eskutcheon/Purr-Patrol-Turret/assets/STLs/motor_bracket.stl

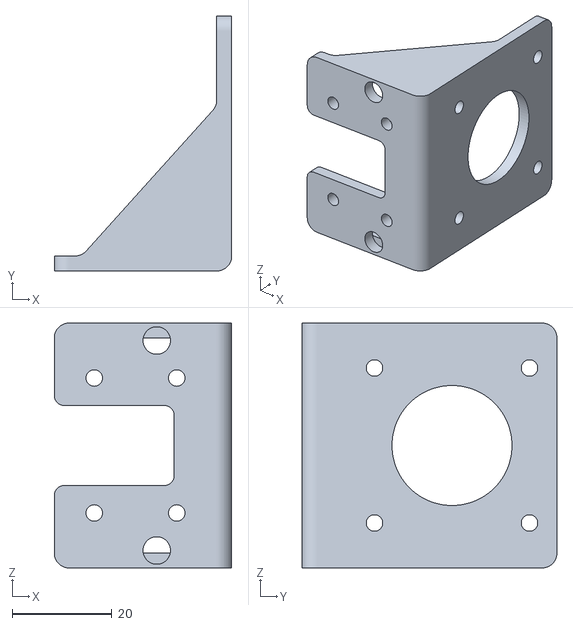
[picture p1: CAD file, 2025-03-24]
assets/STLs/motor_bracket.stl
35.5 x 51.0 x 49.0
