eskutcheon/Purr-Patrol-Turret/assets/STLs/flanged_shaft.stl

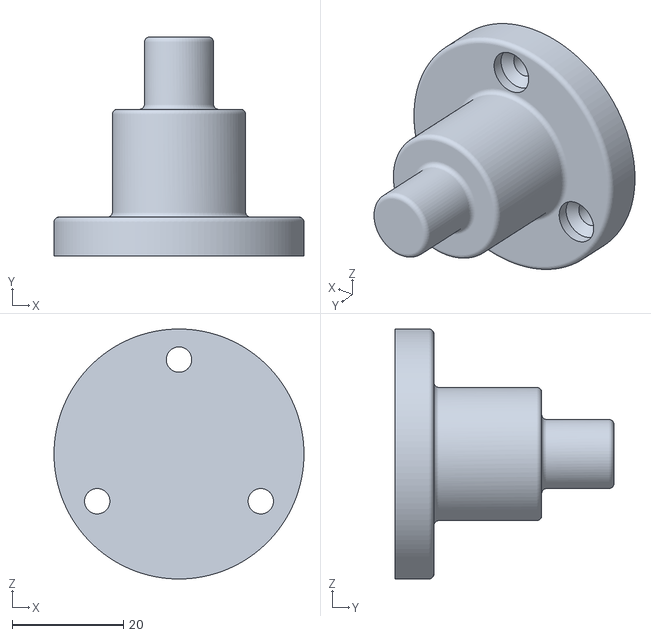
[picture p2: CAD file, 2025-03-24]
assets/STLs/flanged_shaft.stl
45.0 x 39.4 x 45.0
