eskutcheon/Purr-Patrol-Turret/assets/STLs/flanged_collar_prototype.stl

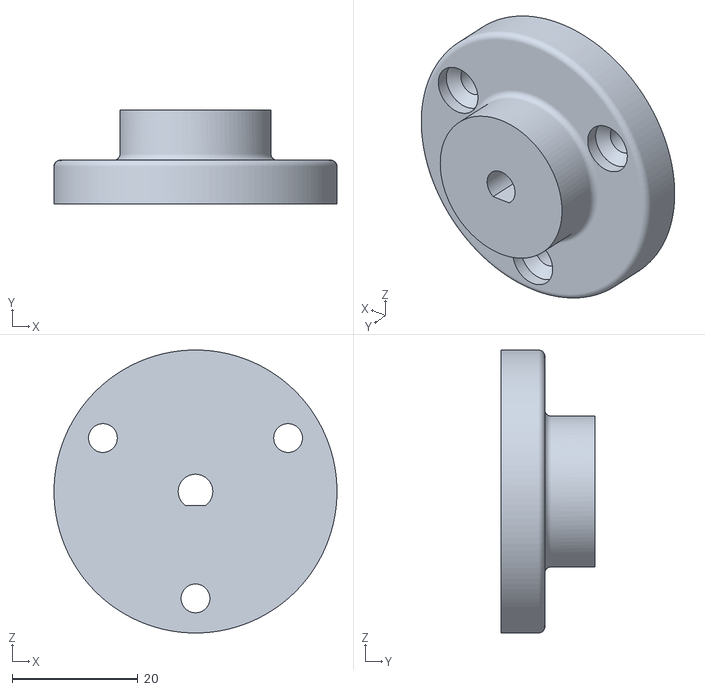
[picture p3: CAD file, 2025-03-24]
assets/STLs/flanged_collar_prototype.stl
45.0 x 15.0 x 45.0
