eskutcheon/Purr-Patrol-Turret/(commit log)

2023-11-06 moved VideoUtils to motion_tracking.py and replaced dependency on deprecated imutils library
    [motion_tracking.py, turret.py]
2023-11-08 added some docs to the repo and made some minor changes to scripts
    [Jetson-Nano-GPIO-mapping.xlsx]
2023-11-19 ongoing tests for motor driver
2023-11-19 added power relay test
2023-11-19 just adding traceback for tests here to review later on another device
2023-11-30 added comments with stuff to do and rewrote a couple redundant snippets in the Turret class
2023-12-05 implemented non-maximum suppression in the box filtering function
2023-12-06 finished targeting code - need to play with threshold and adjust for camera offset
2024-12-24 started working on integrating the object detection better before I end up unplugging my Raspberry Pi and trying the motorhat tests with the Adafruit libraries again
2025-01-22 separated the turret and basic controller logic to support the different modes and aid calibration - will be further extended for operating the turret using the controller as an entry point
    [Jetson-Nano-GPIO-mapping.xlsx]
2025-01-31 started work on camera calibration code based on an algorithm (Zhang 1998) for finding corners on certain calibration pattern and started working on targeting code along with it
2025-02-13 joined relay.py and motor.py into hardward.py, fixed interactive mode and added new methods to test, and fixed minor errors here and there
    [camera.py, controller.py, hardware.py, operations.py, targeting.py, utils.py]
2025-02-14 added a new state to hopefully take over interactive mode tasks - untested until running on Raspberry Pi
2025-02-14 refactored some things into the targeting system, finished adding type annotations, and started working on integrating live camera feeds
2025-02-20 updated the object detection code, confirmed that it was working, and added a couple new networks as Detector options
2025-02-21 committing whatever remains to merge what I've got since I've confirmed the basic camera and turret operations are working
2025-02-25 adding calibration mode to try one last time to compute camera parameters using the new Raspberry Pi camera, described in the new docs
2025-02-28 various changes all over the place as I test this - might have to entirely replace the current motion detector since the method of finding connected components is so much more memory-hungry than I th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
    [camera.py, command.py, controller.py, hardware.py, operations.py, state.py]
2025-02-28 completely rewrote the motion detector back to a numpy and skimage implementation to run on CPU and updated their commands accordingly - also resolved devices in the detectors
    [command.py, controller.py, state.py, test_monitoring.py]
2025-03-01 added logging to the camera feed to better debug things when the Raspberry Pi fails to capture a frame.
    [camera.py]
2025-03-01 changed the threading used in the live video feed display to ensure that unexpected blocking behavior wouldn't happen on the Pi
2025-03-03 added texture map weighting to the motion tracking mask to avoid triggering on just changes in pixel intensity (i.e. turning on a lamp in the room) and added visualizations for contours
    [calibration.py, camera.py, controller.py, hardware.py, operations.py, state.py]
2025-03-04 testing a Matplotlib-based live video feed to see how the Raspberry Pi deals with its multi-threading, since anything else is going to require a much bigger rewrite
2025-03-04 rewrote interactive state classes and functions in the controller to run camera live feeds in the main thread by passing additional functions to the states
2025-03-05 wrote an implementation for using libcamera as the camera feed backend given how much work it is to build OpenCV from source with Gstreamer
2025-03-06 confirmed working in all modes on the Raspberry Pi using picamera2, though small issues remain
    [camera_opencv.py, camera_rpi.py, controller.py]
2025-03-13 small changes to the camera feed classes for the Pi
2025-03-24 updated README and various little things while debugging on Raspberry Pi
    [flanged_collar_prototype.stl, flanged_shaft.stl, motor_bracket.stl]
